dmeat-art/DMT-Nixie-clock-amp/Concept-art/2017-05.png

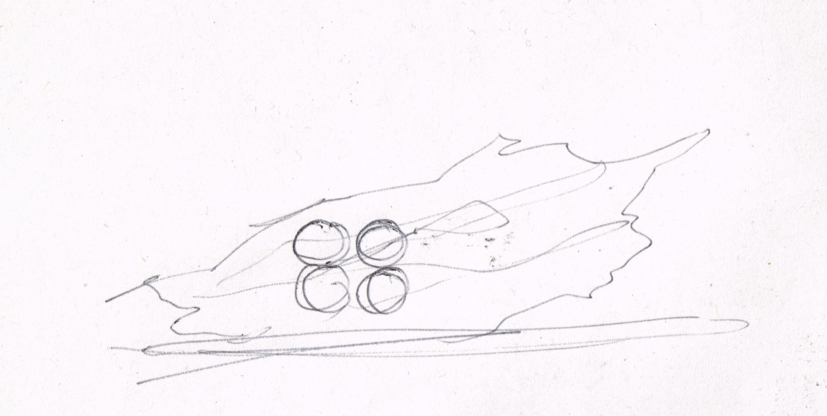
Concept-art/2017-05.png
