dmeat-art/DMT-Nixie-clock-amp/Concept-art/2017-07.png

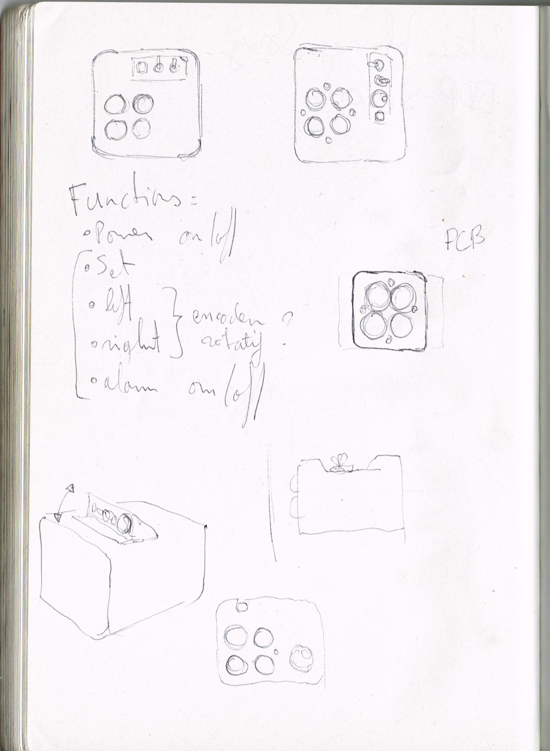
Concept-art/2017-07.png
