dmeat-art/DMT-Nixie-clock-amp/Concept-art/2017-08.png

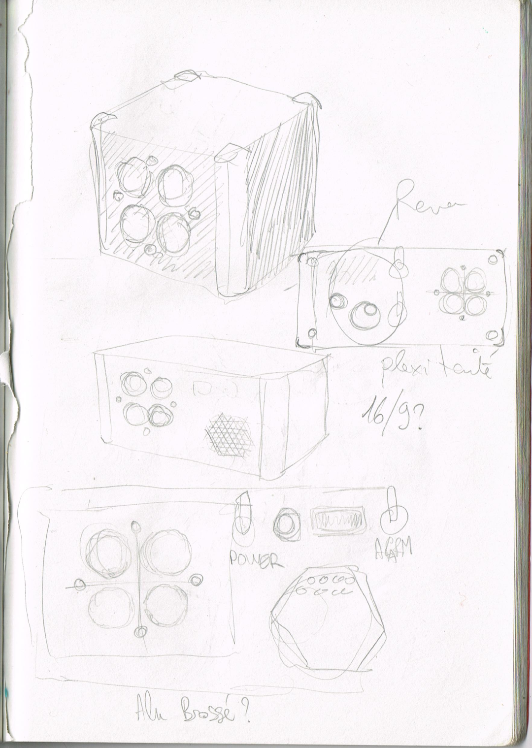
Concept-art/2017-08.png
