dmeat-art/DMT-Nixie-clock-amp/Concept-art/2017-11.png

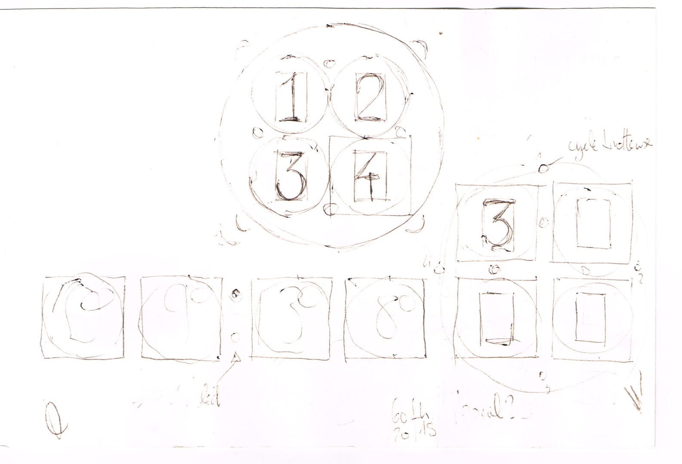
Concept-art/2017-11.png
