dmeat-art/DMT-Nixie-clock-amp/PCB/pcb-final.pdf

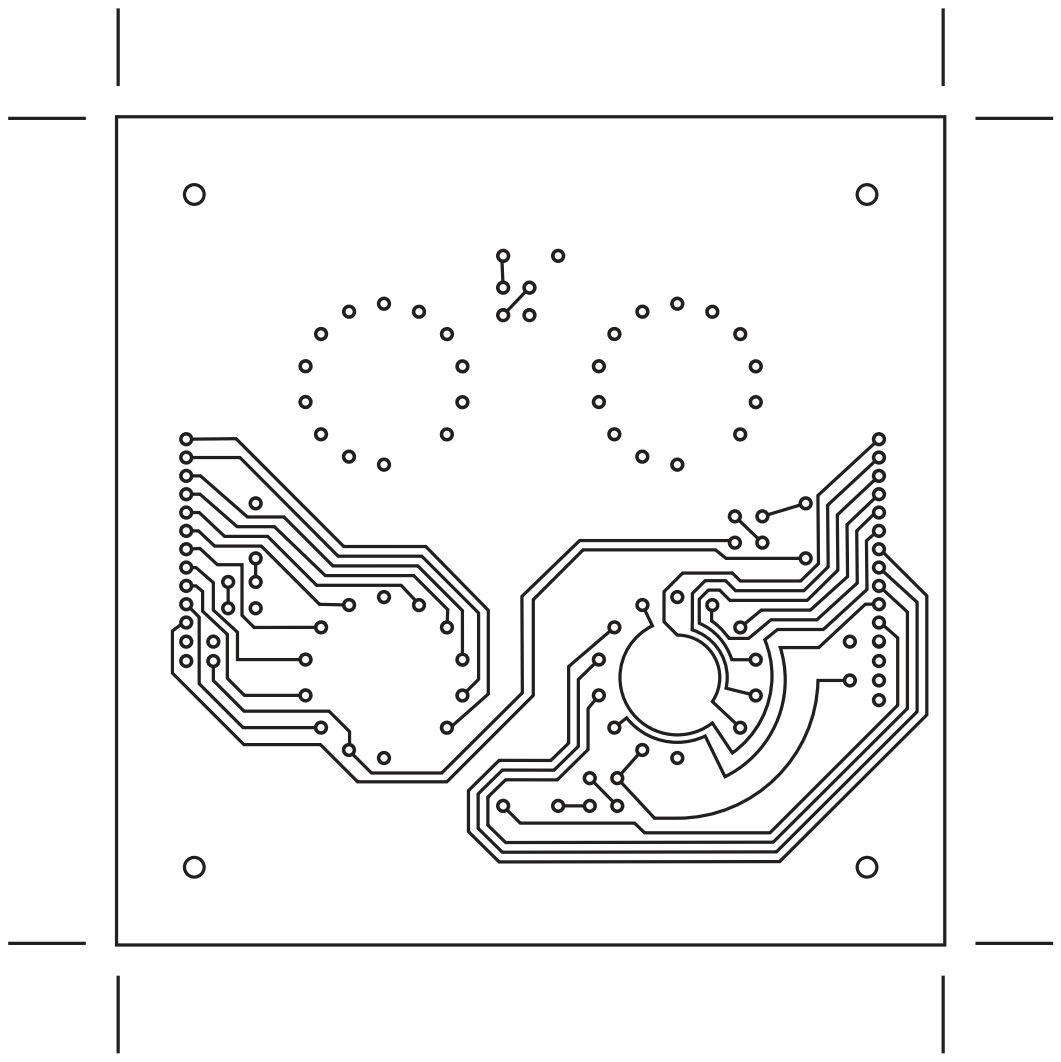
[picture p29: page 1]

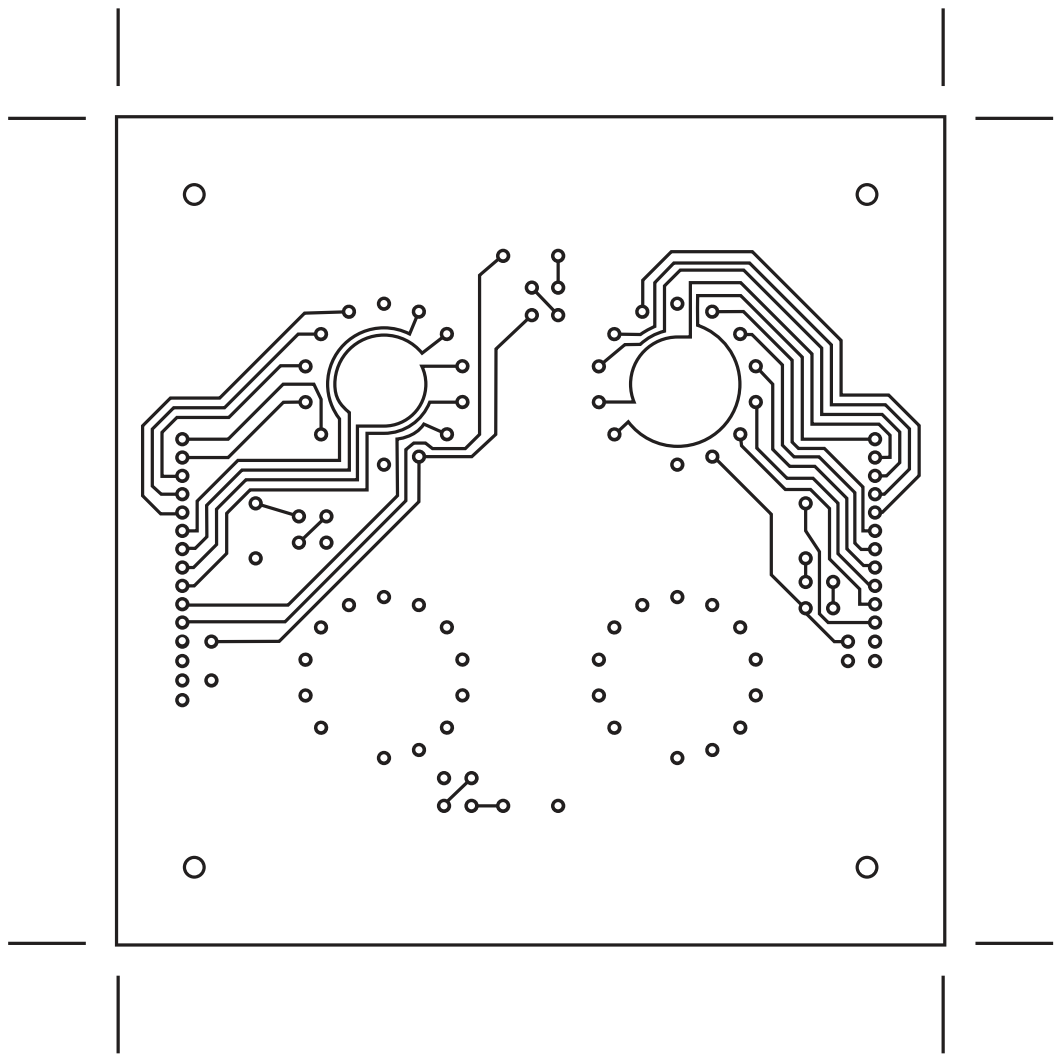
[picture p30: page 2]
